arlosi/sawsetter/README.md

### Software and KiCad for Handsaw Setting Robot
