arlosi/sawsetter/sawsetter_main/sawsetter_main.kicad_pcb

## KiCad design sawsetter_main/sawsetter_main.kicad_pcb (2022-03-02)

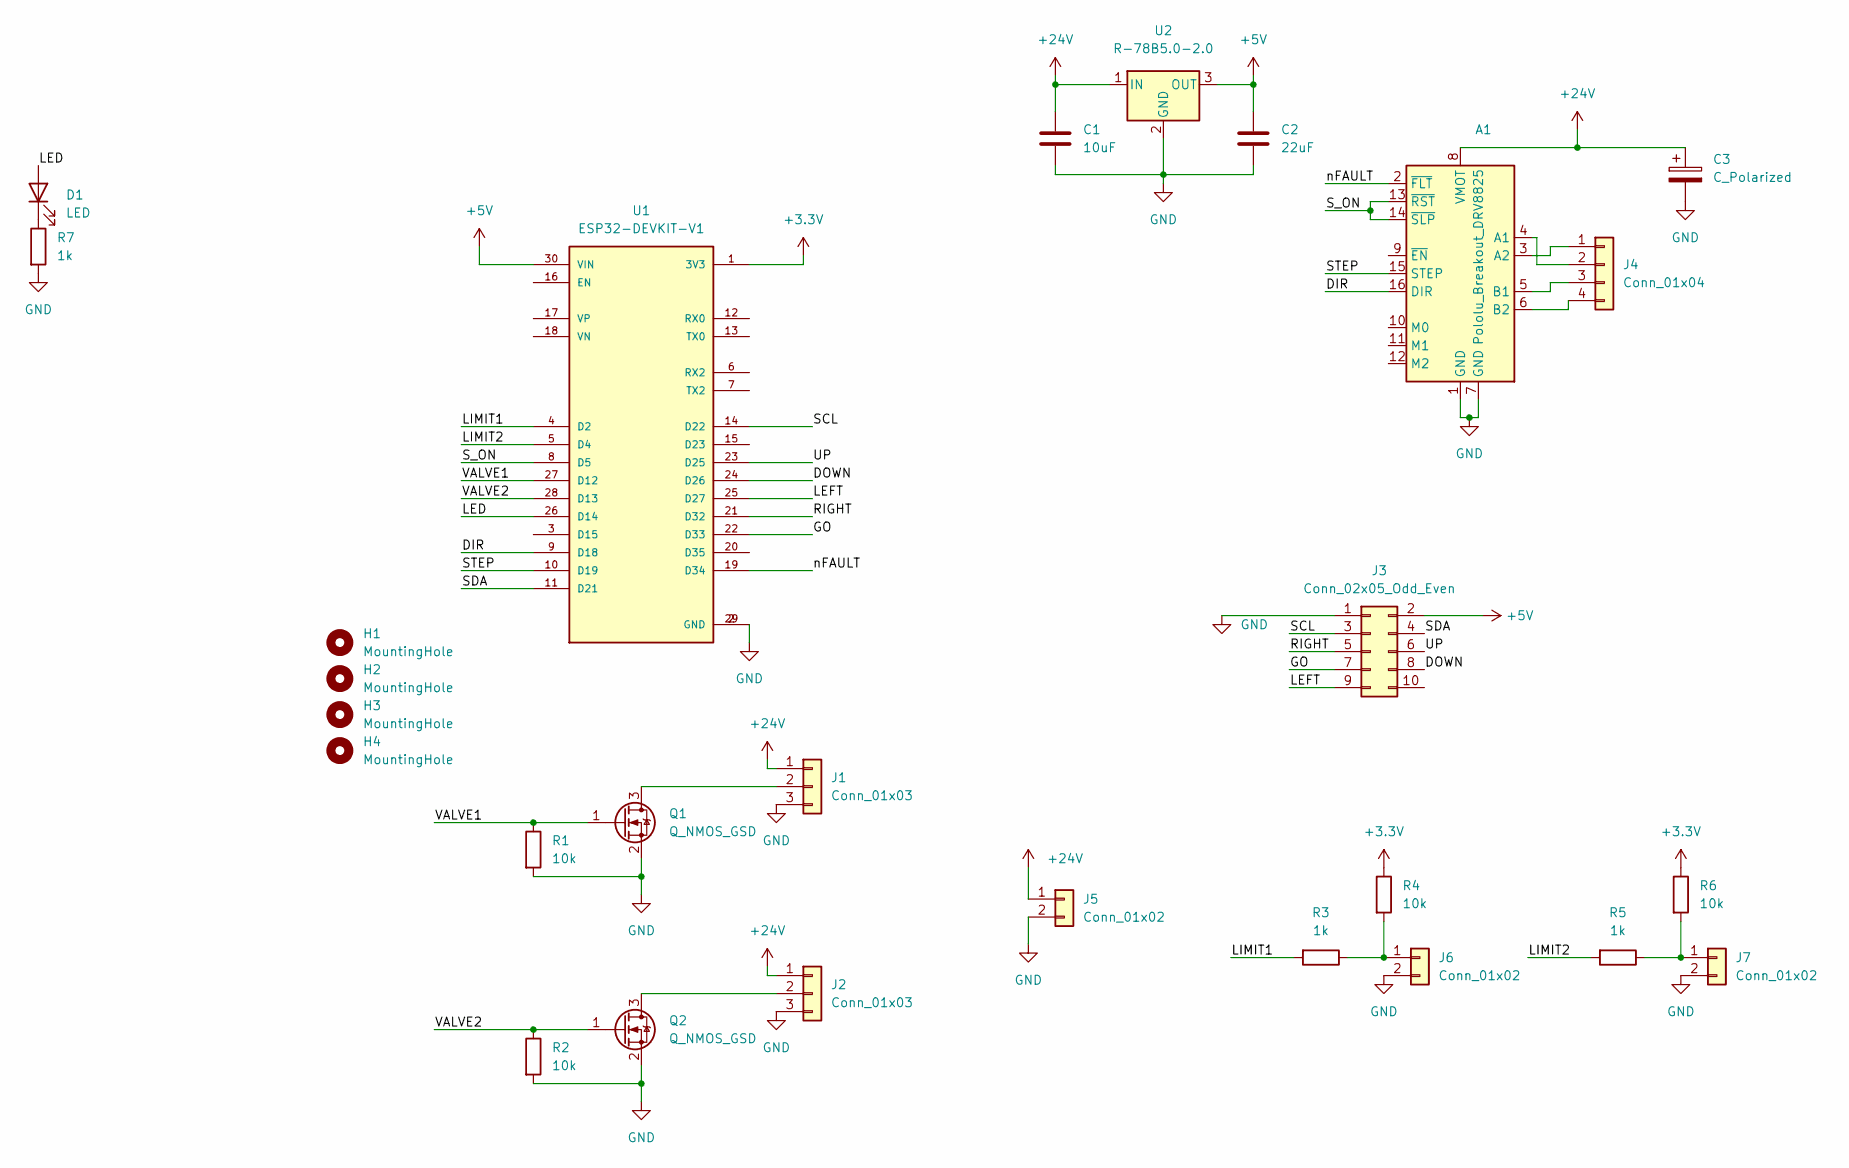
[picture p1: schematic sawsetter_main.kicad_sch]

Parts:
A1: Pololu_Breakout_DRV8825; Pololu_Breakout-16_15.2x20.3mm
C1: 10uF; C_1206_3216Metric_Pad1.33x1.80mm_HandSolder
C2: 22uF; C_0603_1608Metric_Pad1.08x0.95mm_HandSolder
C3: C_Polarized; CP_Radial_D10.0mm_P5.00mm
D1: LED; LED_0805_2012Metric_Pad1.15x1.40mm_HandSolder
H1, H2, H3, H4: MountingHole; MountingHole_4.3mm_M4
J1, J2: Conn_01x03; PhoenixContact_MC_1,5_3-G-3.81_1x03_P3.81mm_Horizontal
J3: Conn_02x05_Odd_Even; IDC-Header_2x05_P2.54mm_Vertical
J4: Conn_01x04; PhoenixContact_MC_1,5_4-G-3.81_1x04_P3.81mm_Horizontal
J5: Conn_01x02; PhoenixContact_MC_1,5_2-G-5.08_1x02_P5.08mm_Horizontal
J6, J7: Conn_01x02; PhoenixContact_MC_1,5_2-G-3.81_1x02_P3.81mm_Horizontal
Q1, Q2: Q_NMOS_GSD; TSOT-23_HandSoldering
R1, R2, R4, R6: 10k; R_0603_1608Metric_Pad0.98x0.95mm_HandSolder
R3, R5, R7: 1k; R_0603_1608Metric_Pad0.98x0.95mm_HandSolder
U1: ESP32-DEVKIT-V1; MODULE_ESP32_DEVKIT_V1; PARTREV N/A
U2: R-78B5.0-2.0; Converter_DCDC_RECOM_R-78B-2.0_THT

Connections:
+3V3: R4.1, R6.1, U1.1 (3V3)
+5V: C2.1, J3.2, U1.30 (VIN), U2.3 (OUT)
+24V: A1.8 (VMOT), C1.1, C3.1, J1.1, J2.1, J5.1, U2.1 (IN)
/DIR: A1.16 (DIR), U1.9 (D18)
/DOWN: J3.8, U1.24 (D26)
/GO: J3.7, U1.22 (D33)
/LED: D1.2 (A), U1.26 (D14)
/LEFT: J3.9, U1.25 (D27)
/LIMIT1: R3.2, U1.4 (D2)
/LIMIT2: R5.2, U1.5 (D4)
/RIGHT: J3.5, U1.21 (D32)
/SCL: J3.3, U1.14 (D22)
/SDA: J3.4, U1.11 (D21)
/STEP: A1.15 (STEP), U1.10 (D19)
/S_ON: A1.13 (~RST), A1.14 (~SLP), U1.8 (D5)
/UP: J3.6, U1.23 (D25)
/VALVE1: Q1.1 (G), R1.1, U1.27 (D12)
/VALVE2: Q2.1 (G), R2.1, U1.28 (D13)
/nFAULT: A1.2 (~FLT), U1.19 (D34)
GND: A1.1 (GND), A1.7 (GND), C1.2, C2.2, C3.2, J1.3, J2.3, J3.1, J5.2, J6.2, J7.2, Q1.2 (S), Q2.2 (S), R1.2, R2.2, R7.2, U1.2 (GND), U1.29 (GND), U2.2 (GND)
unnamed: A1.3 (A2), J4.1
unnamed: A1.4 (A1), J4.2
unnamed: A1.5 (B1), J4.3
unnamed: A1.6 (B2), J4.4
unnamed: D1.1 (K), R7.1
unnamed: J1.2, Q1.3 (D)
unnamed: J2.2, Q2.3 (D)
unnamed: J6.1, R3.1, R4.2
unnamed: J7.1, R5.1, R6.2

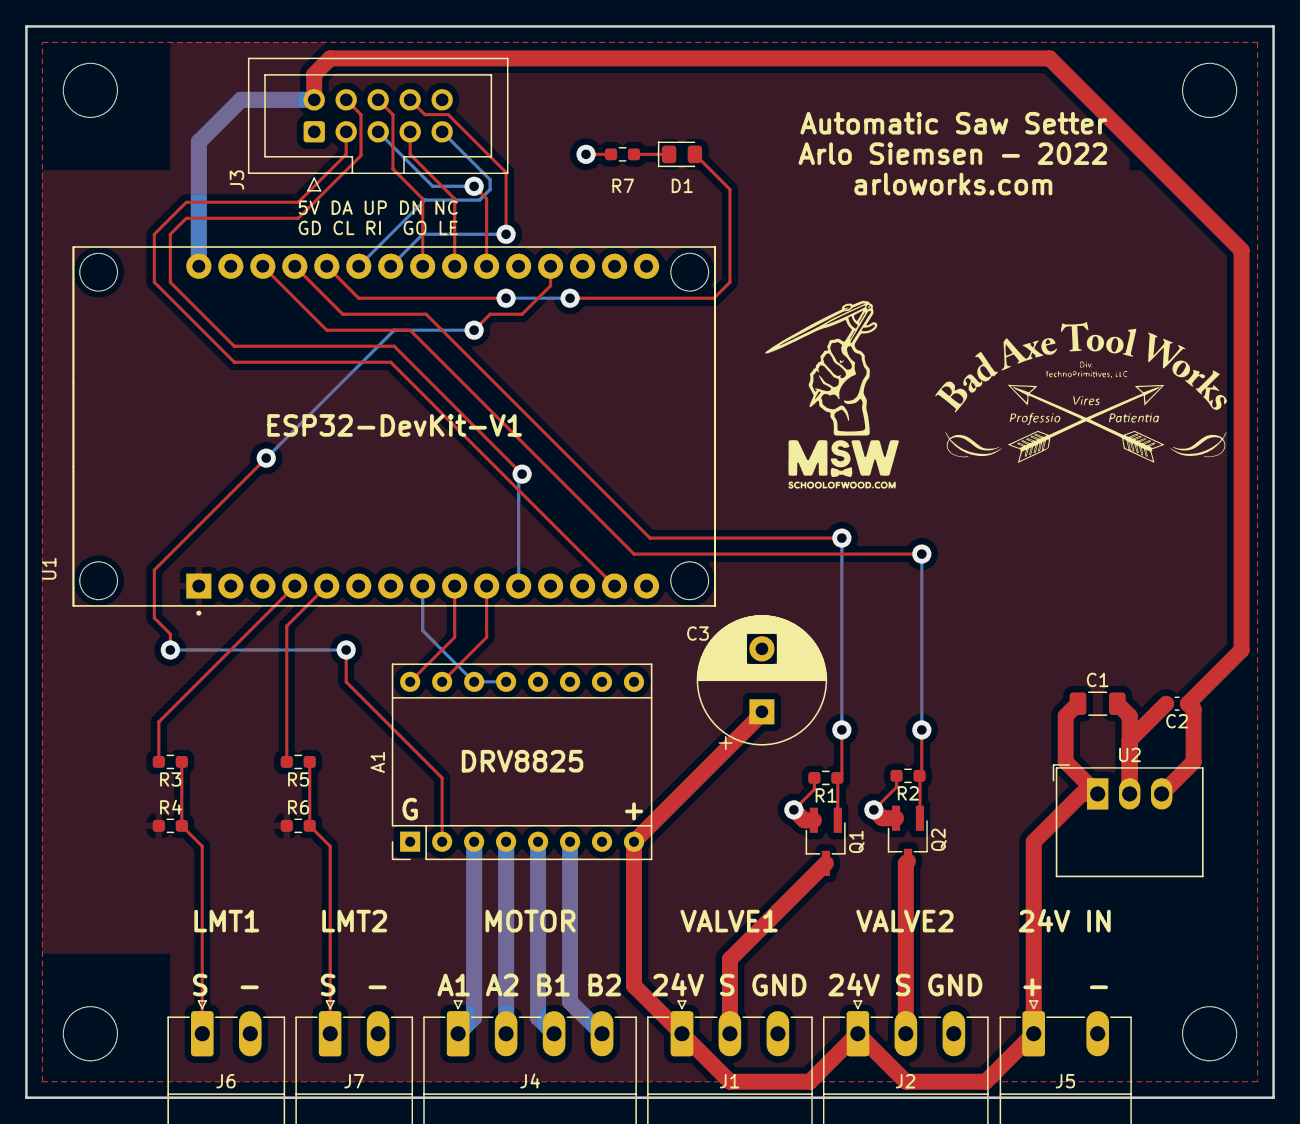
[picture p2: board sawsetter_main.kicad_pcb from above]

Board: 2 copper layers, 99.1 x 85.1 mm, 27 parts (0 on the bottom side), 29 nets.
