arlosi/sawsetter/sawsetter_buttons/sawsetter_buttons.kicad_pcb

## KiCad design sawsetter_buttons/sawsetter_buttons.kicad_pcb (2022-03-02)

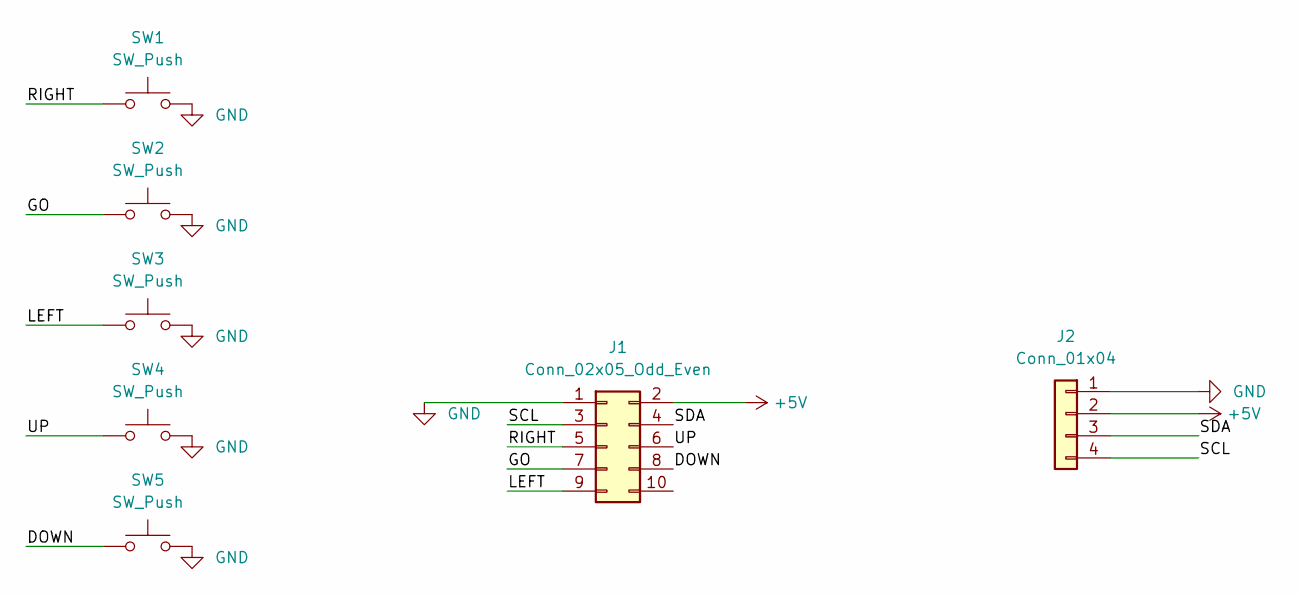
[picture p3: schematic sawsetter_buttons.kicad_sch]

Parts:
J1: Conn_02x05_Odd_Even; IDC-Header_2x05_P2.54mm_Vertical
J2: Conn_01x04; PinHeader_1x04_P2.54mm_Horizontal
SW1, SW2, SW3, SW4, SW5: SW_Push; SW_PUSH-12mm_Wuerth-430476085716

Connections:
+5V: J1.2, J2.2
/DOWN: J1.8, SW5.1
/GO: J1.7, SW2.1
/LEFT: J1.9, SW3.1
/RIGHT: J1.5, SW1.1
/SCL: J1.3, J2.4
/SDA: J1.4, J2.3
/UP: J1.6, SW4.1
GND: J1.1, J2.1, SW1.2, SW2.2, SW3.2, SW4.2, SW5.2

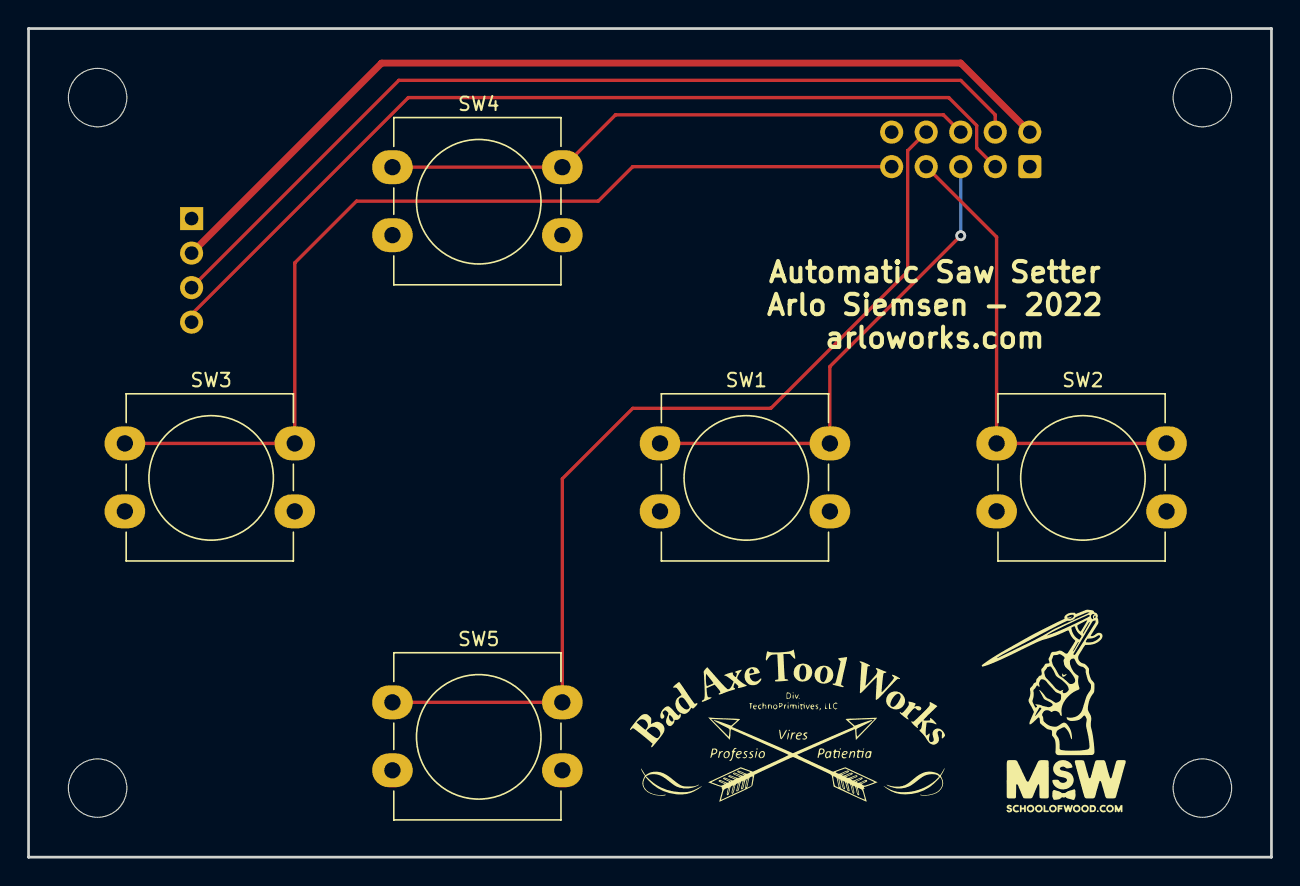
[picture p4: board sawsetter_buttons.kicad_pcb from above]

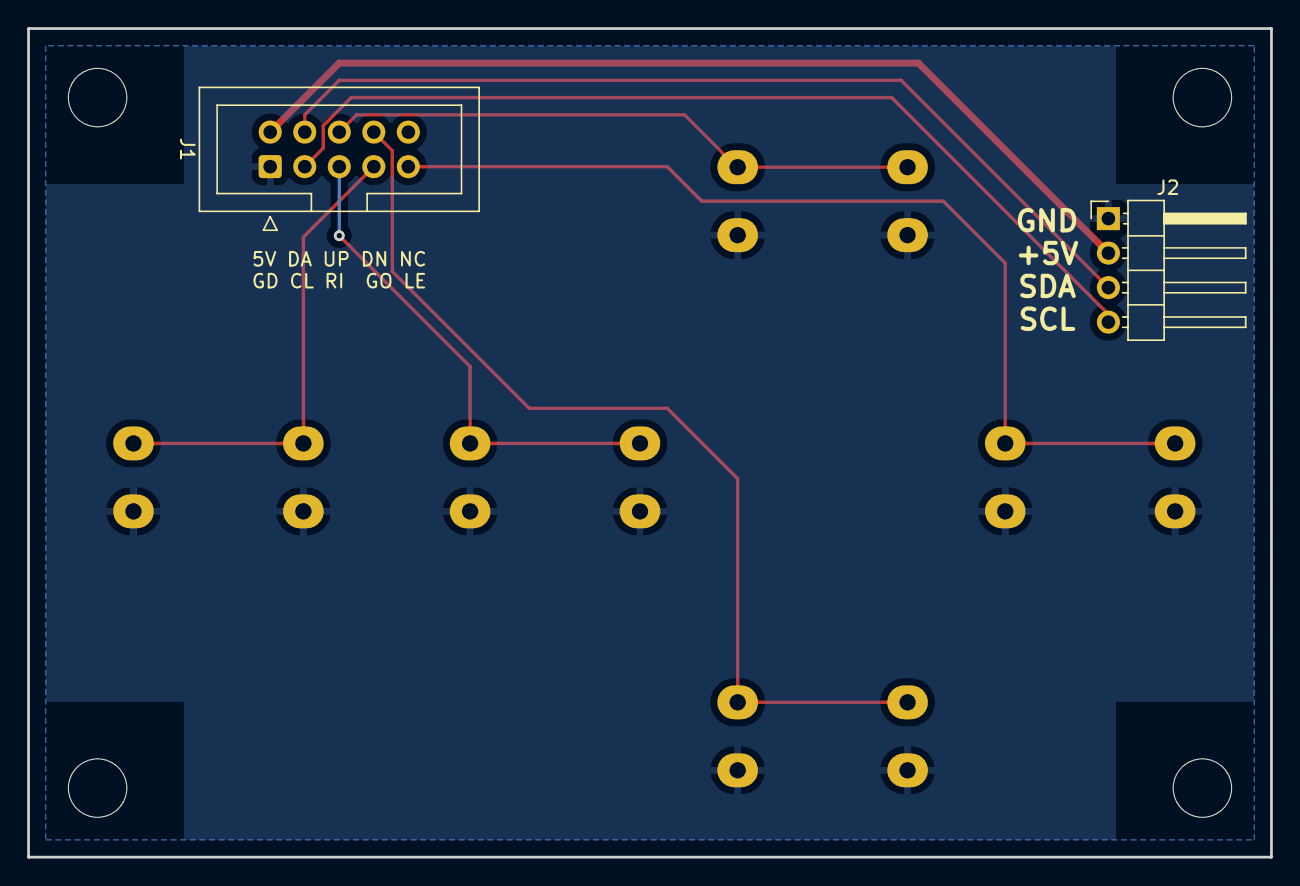
[picture p5: board sawsetter_buttons.kicad_pcb from below]

Board: 2 copper layers, 91.4 x 61.0 mm, 11 parts (2 on the bottom side), 9 nets.

Other parts of the board:
H1, H1#2, H1#3, H1#4: MountingHole; MountingHole_4.3mm_M4
