arlosi/sawsetter/(commit log)

2022-04-03 initial prototype working
2022-09-03 Add calibration
2022-09-03 added laser support
2022-09-13 Add length calibration
